DeepFocusAU/Gas-Label-Printer-for-DiveSoft-HE-O2-Analyser/hardware/enclosure/Cradle.stl

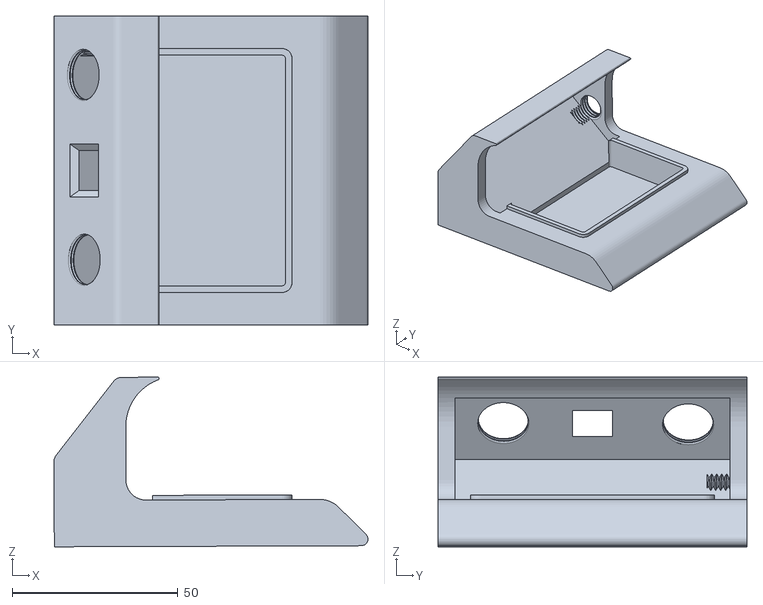
[picture p12: CAD file, 2026-11-08]
hardware/enclosure/Cradle.stl
94.6 x 93.0 x 51.1
