DeepFocusAU/Gas-Label-Printer-for-DiveSoft-HE-O2-Analyser/hardware/enclosure/Dongle.stl

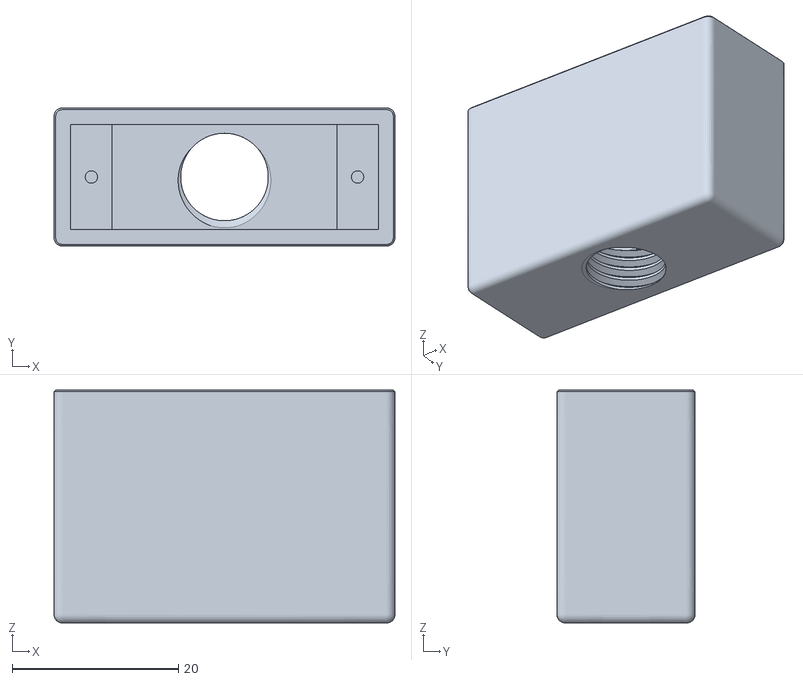
[picture p13: CAD file, 2026-11-08]
hardware/enclosure/Dongle.stl
41.0 x 16.6 x 28.0
