DeepFocusAU/Gas-Label-Printer-for-DiveSoft-HE-O2-Analyser/(list of files, cad)

Other CAD files:
hardware/enclosure/DiveSoft-PrinterDisplay.f3d
hardware/enclosure/DiveSoft-Program-Dongle.f3d
