DeepFocusAU/Gas-Label-Printer-for-DiveSoft-HE-O2-Analyser/(commit log)

2026-11-08 Initial commit: Gas Label Printer for DiveSoft HE/O2 Analyser
    ESP32-C3 firmware, README and GitHub Pages site in docs/.
2026-11-08 Add wiring diagram for analyser, level converter, ESP32-C3 and print switch
2026-11-08 Add photo of printed labels; name Detonger DP230S printer and 50x50 mm labels
2026-11-08 Link the ESP32-C3 0.42" OLED board used
2026-11-08 Add Detonger DP230S printer and label specs
2026-11-08 Add Detonger DP230S printer picture
2026-11-08 Add photo gallery: labels on cylinders, board with printer, early labels
2026-11-08 Add background, label durability and improvement ideas; correct power note
2026-11-08 Add demo video and 3D-printed dongle and cradle files
    [Cradle.stl, DiveSoft-PrinterDisplay.f3d, DiveSoft-Program-Dongle.f3d, Dongle.stl]
2026-11-08 Wiring: add 9 V boost and 5 V step-down from printer battery, DVI pin 24, SM12 glands
2026-11-10 Add Bluetooth version and build parts lists for wired and Bluetooth versions
    Bluetooth mode firmware (board powered from analyser pin 13, MOD label on
    long press, auto-off, saved printer address), wiring diagram, photos and
    demo video, plus separate parts lists for each version.
2026-11-10 Show Bluetooth photos, video and wiring; move finished ideas to a Done list
